aaronkoolkoder/smartrep-ece198/output/pdf/station_qr_codes.pdf

smartrep. | SCAN & LIFT

# Dumbbells - 3 lb

Open SmartRep and scan this station to begin.

db-3lb | Student prototype - fake data only
smartrep. | SCAN & LIFT

# Dumbbells - 5 lb

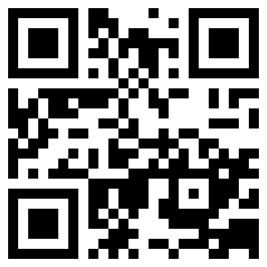
[picture p1: figure]

Open SmartRep and scan this station to begin.

db-5lb | Student prototype - fake data only

# Dumbbells - 8 lb

Open SmartRep and scan this station to begin.

db-8lb | Student prototype - fake data only
smartrep. | SCAN & LIFT

# Kettlebell - 10 lb

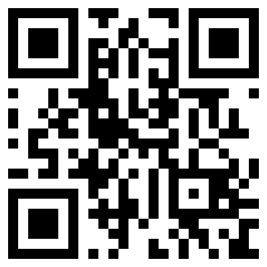
[picture p2: figure]

Open SmartRep and scan this station to begin.

kb-10lb | Student prototype - fake data only

# Movement glove

Open SmartRep and scan this station to begin.

glove-1 | Student prototype - fake data only
