aaronkoolkoder/smartrep-ece198/output/pdf/qr_db-3lb.png

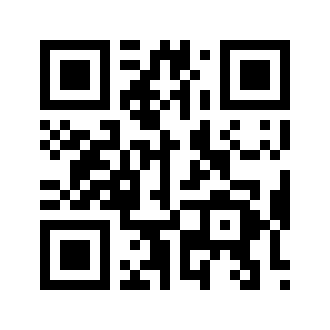
output/pdf/qr_db-3lb.png
