aaronkoolkoder/smartrep-ece198/output/pdf/qr_db-5lb.png

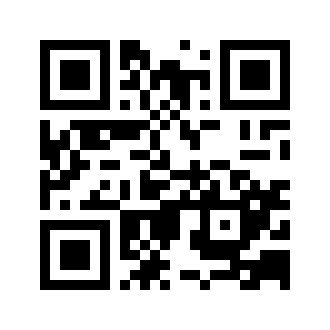
output/pdf/qr_db-5lb.png
