aaronkoolkoder/smartrep-ece198/output/pdf/qr_db-8lb.png

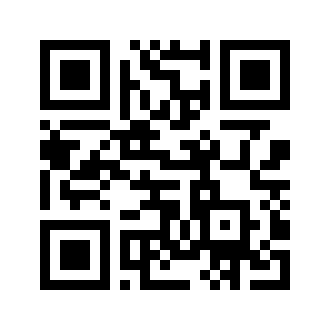
output/pdf/qr_db-8lb.png
