aaronkoolkoder/smartrep-ece198/output/pdf/qr_glove-1.png

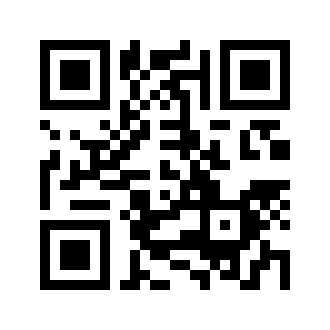
output/pdf/qr_glove-1.png
