aaronkoolkoder/smartrep-ece198/output/pdf/qr_kb-10lb.png

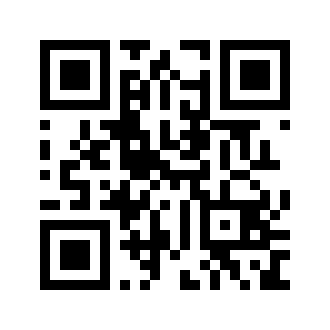
output/pdf/qr_kb-10lb.png
