aaronkoolkoder/smartrep-ece198/bridge/smartrep/sources/base.py

"""Sources deliver raw samples; rep detection will stay outside this layer."""
from typing import Awaitable, Callable, Protocol

SampleCallback = Callable[[str, dict], Awaitable[None]]


class SensorSource(Protocol):
    def devices(self) -> list[dict]: ...
    async def start(self, device_id: str) -> None: ...
    async def stop(self, device_id: str) -> None: ...
    async def close(self) -> None: ...
