aaronkoolkoder/smartrep-ece198/(commit log)

2026-11-04 Initial SmartRep prototype with simulation and mobile app
2026-11-06 Connect MMA7361 hardware, LCD calibration feedback and buzzer
    [build_hardware_guide.py, hardware_source.py, launch_phone.py]
